arsinovgleb5-create/Mikola_Tesla-QCW-DRSSTC-controller/hardware/control_board/output/3d_bottom.png

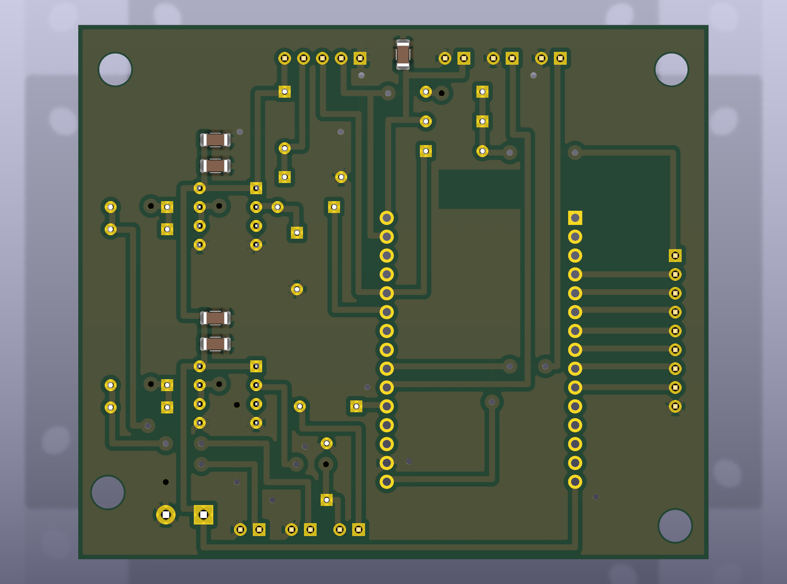
hardware/control_board/output/3d_bottom.png
