arsinovgleb5-create/Mikola_Tesla-QCW-DRSSTC-controller/hardware/control_board/output/bottom_copper.png

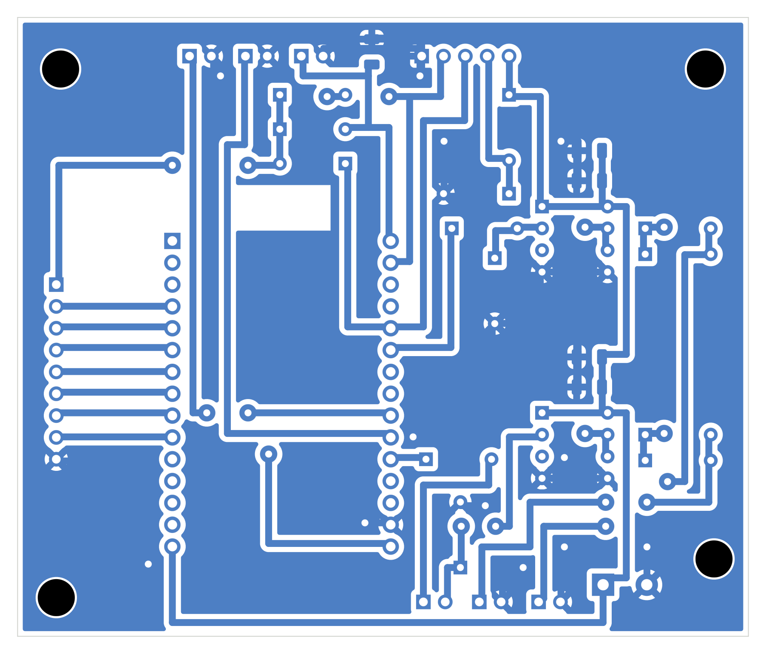
hardware/control_board/output/bottom_copper.png
