arsinovgleb5-create/Mikola_Tesla-QCW-DRSSTC-controller/hardware/control_board/output/schematic.png

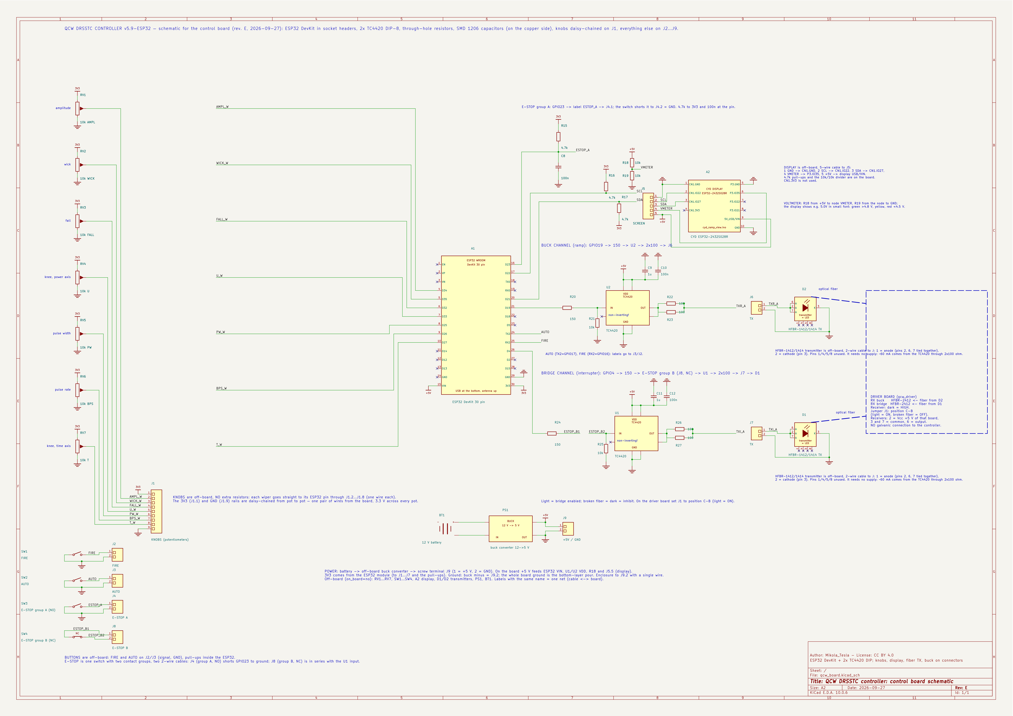
hardware/control_board/output/schematic.png
