arsinovgleb5-create/Mikola_Tesla-QCW-DRSSTC-controller/hardware/control_board/output/bottom_assembly.pdf

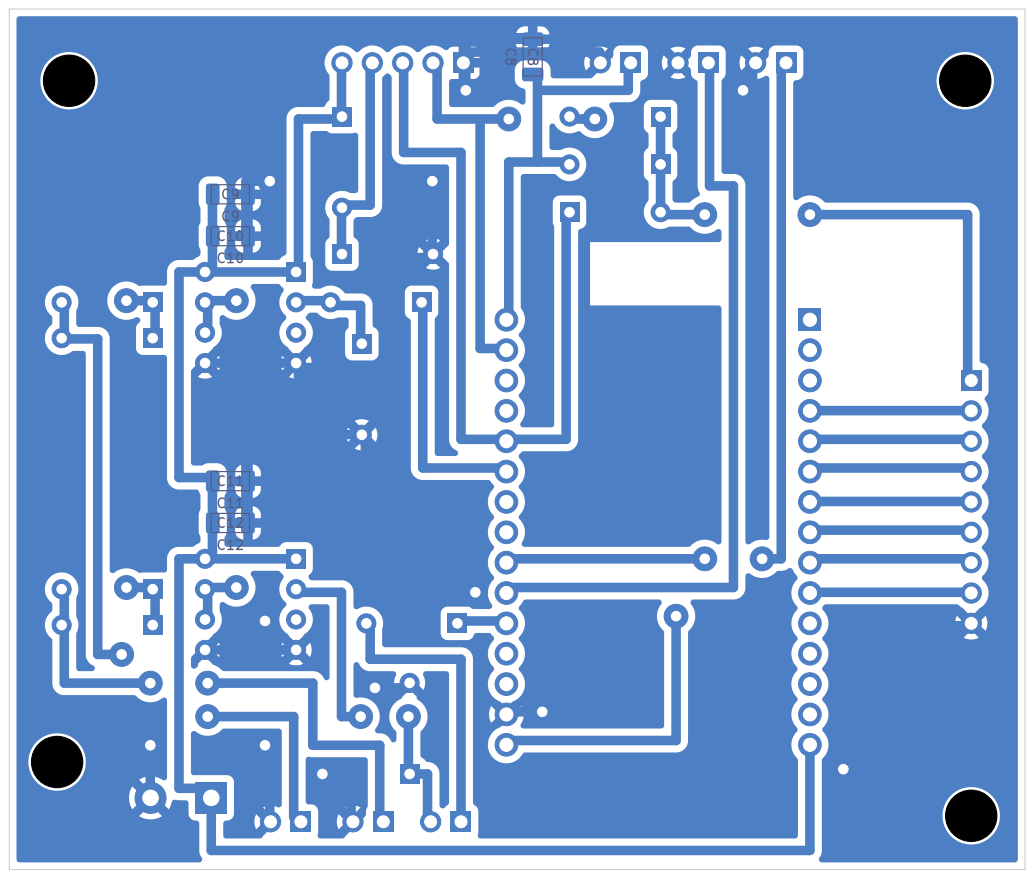
[picture p5: page 1]

Size: A4 | Rev:
KiCad E.D.A. 10.0.6 | Id: 1/1
