arsinovgleb5-create/Mikola_Tesla-QCW-DRSSTC-controller/hardware/control_board/output/top_assembly.pdf

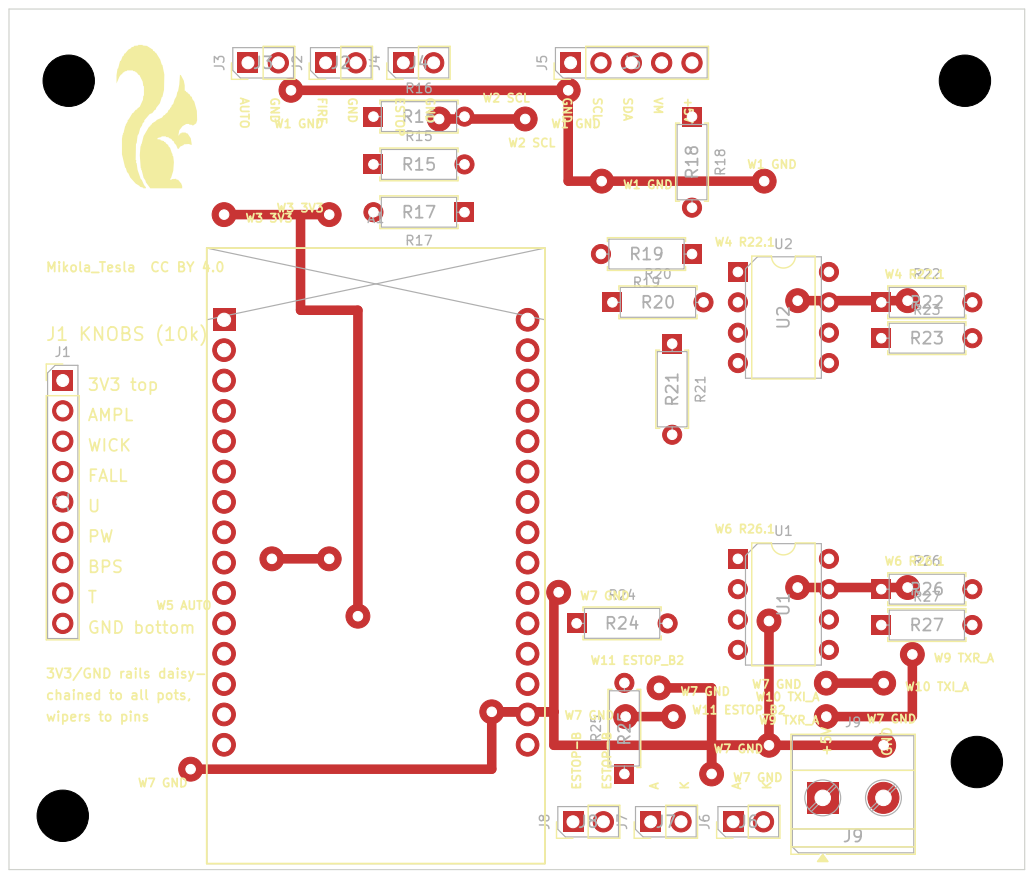
[picture p7: page 1]

AK AUTO GND FIRE GND ESTOP GND GND SCL SDA VM+5V Mikola_Tesla CC BY 4.0

Size: A4 | Rev:
KiCad E.D.A. 10.0.6 | Id: 1/1
