arsinovgleb5-create/Mikola_Tesla-QCW-DRSSTC-controller/hardware/control_board/output/bottom_copper_1to1.pdf

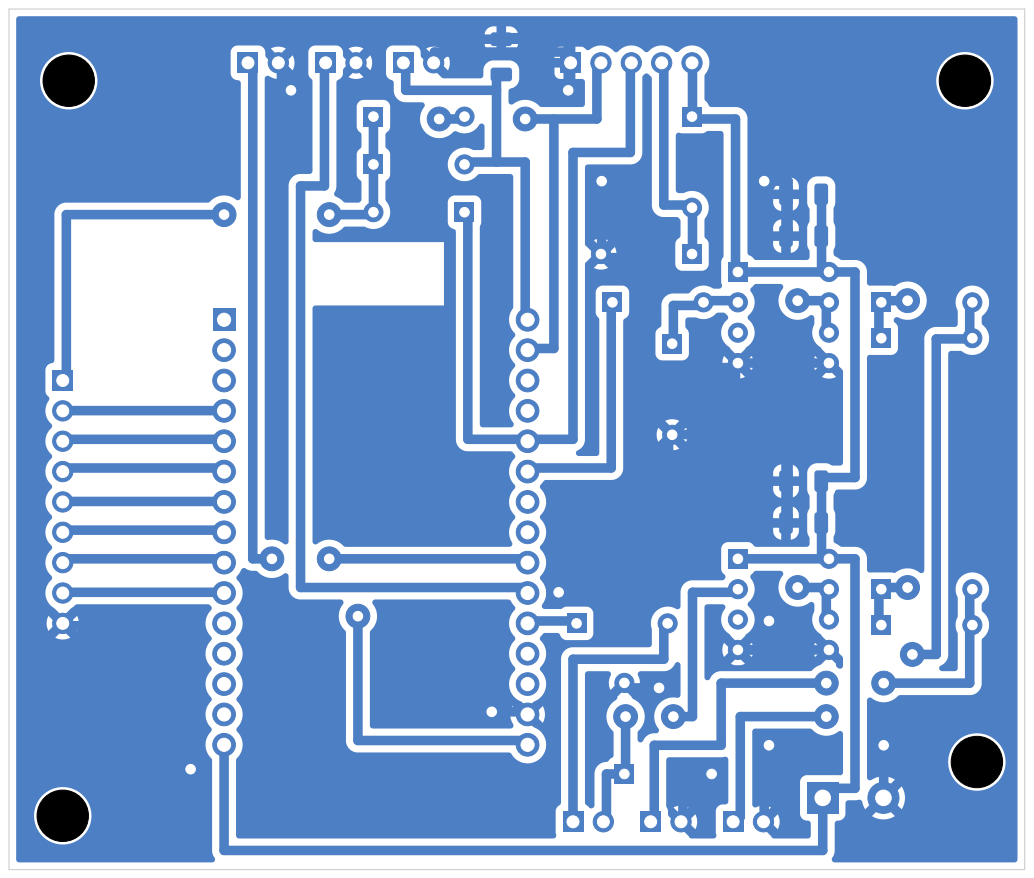
[picture p8: page 1]
