arsinovgleb5-create/Mikola_Tesla-QCW-DRSSTC-controller/hardware/control_board/output/bottom_copper_1to1_mirrored.pdf

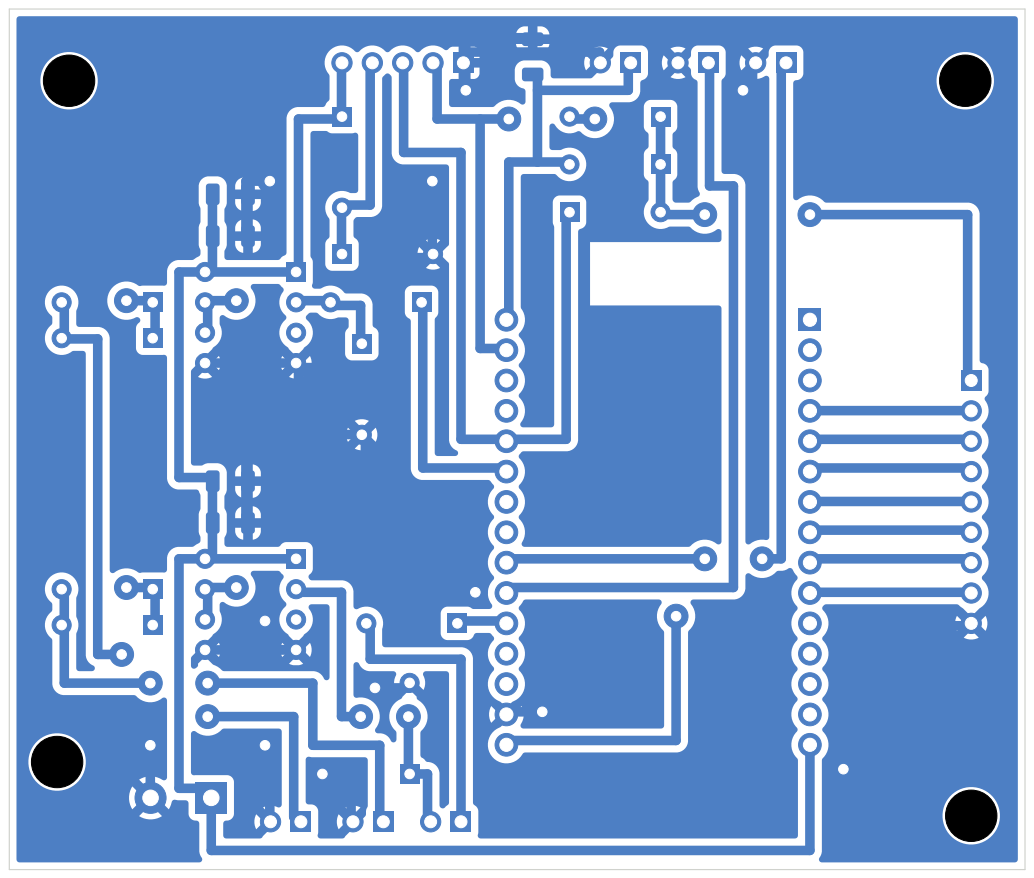
[picture p9: page 1]
