arsinovgleb5-create/Mikola_Tesla-QCW-DRSSTC-controller/hardware/control_board/output/drill_map.pdf

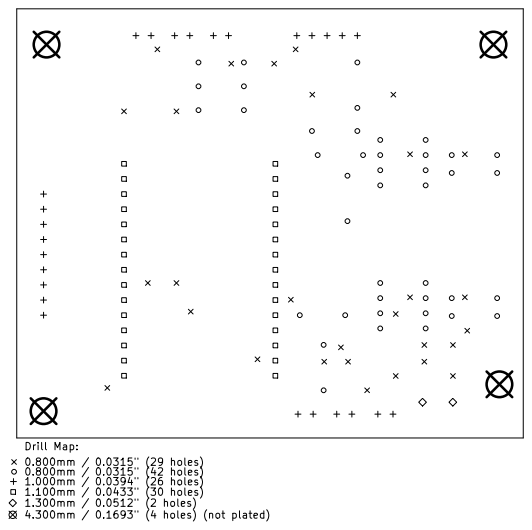
[picture p10: page 1]
