arsinovgleb5-create/Mikola_Tesla-QCW-DRSSTC-controller/hardware/control_board/kicad/qcw_board.kicad_pcb

## KiCad design hardware/control_board/kicad/qcw_board.kicad_pcb (2026-09-27)

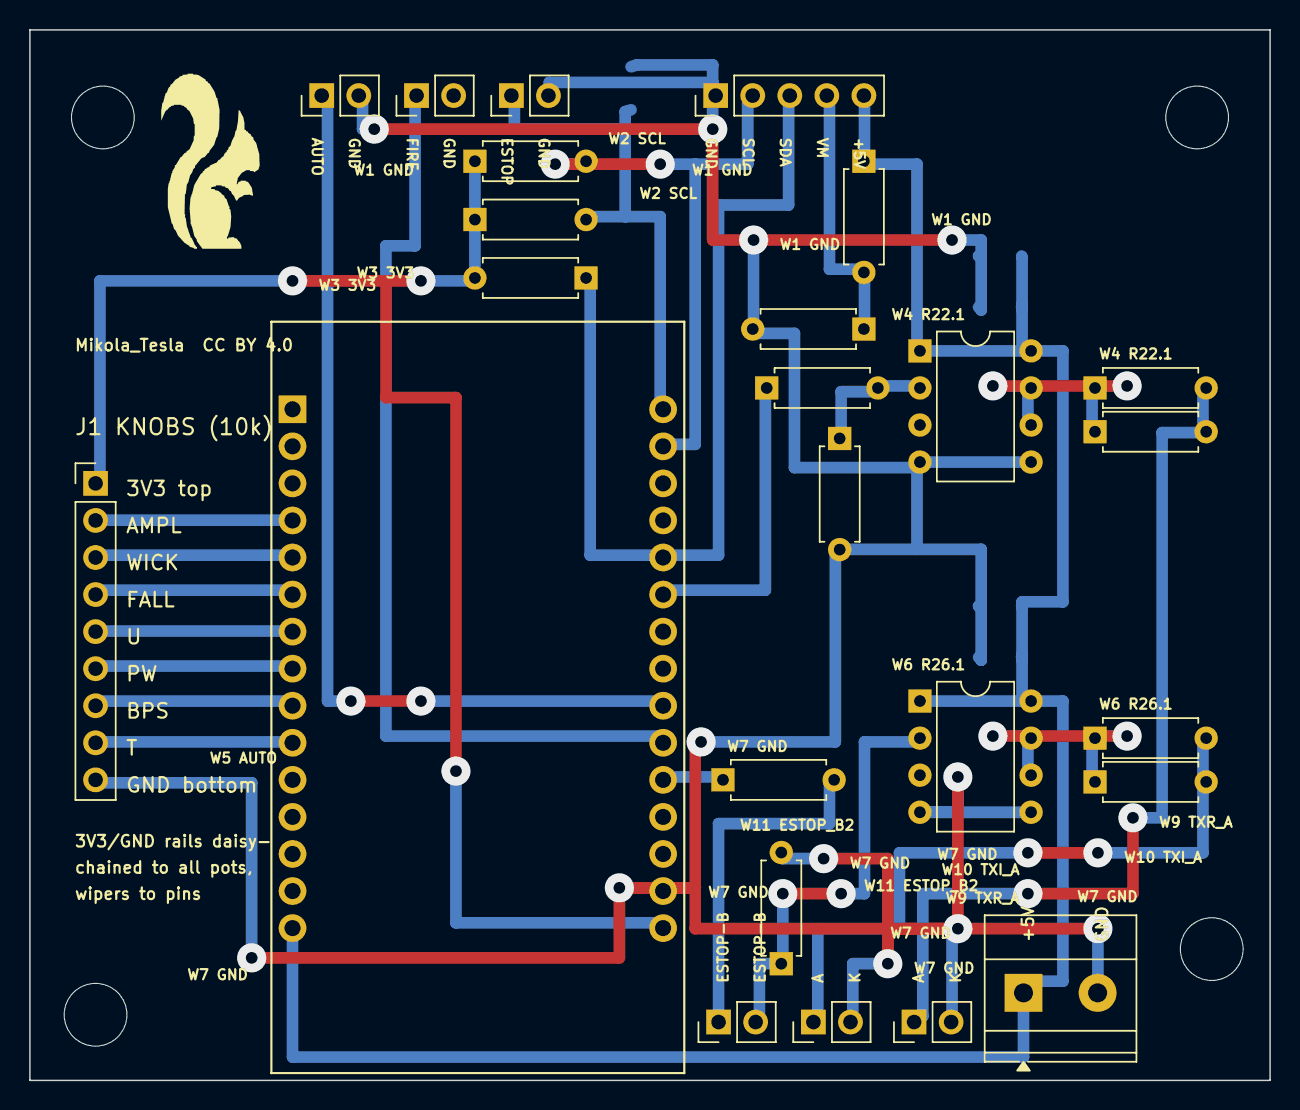
[picture p11: board qcw_board.kicad_pcb from above]

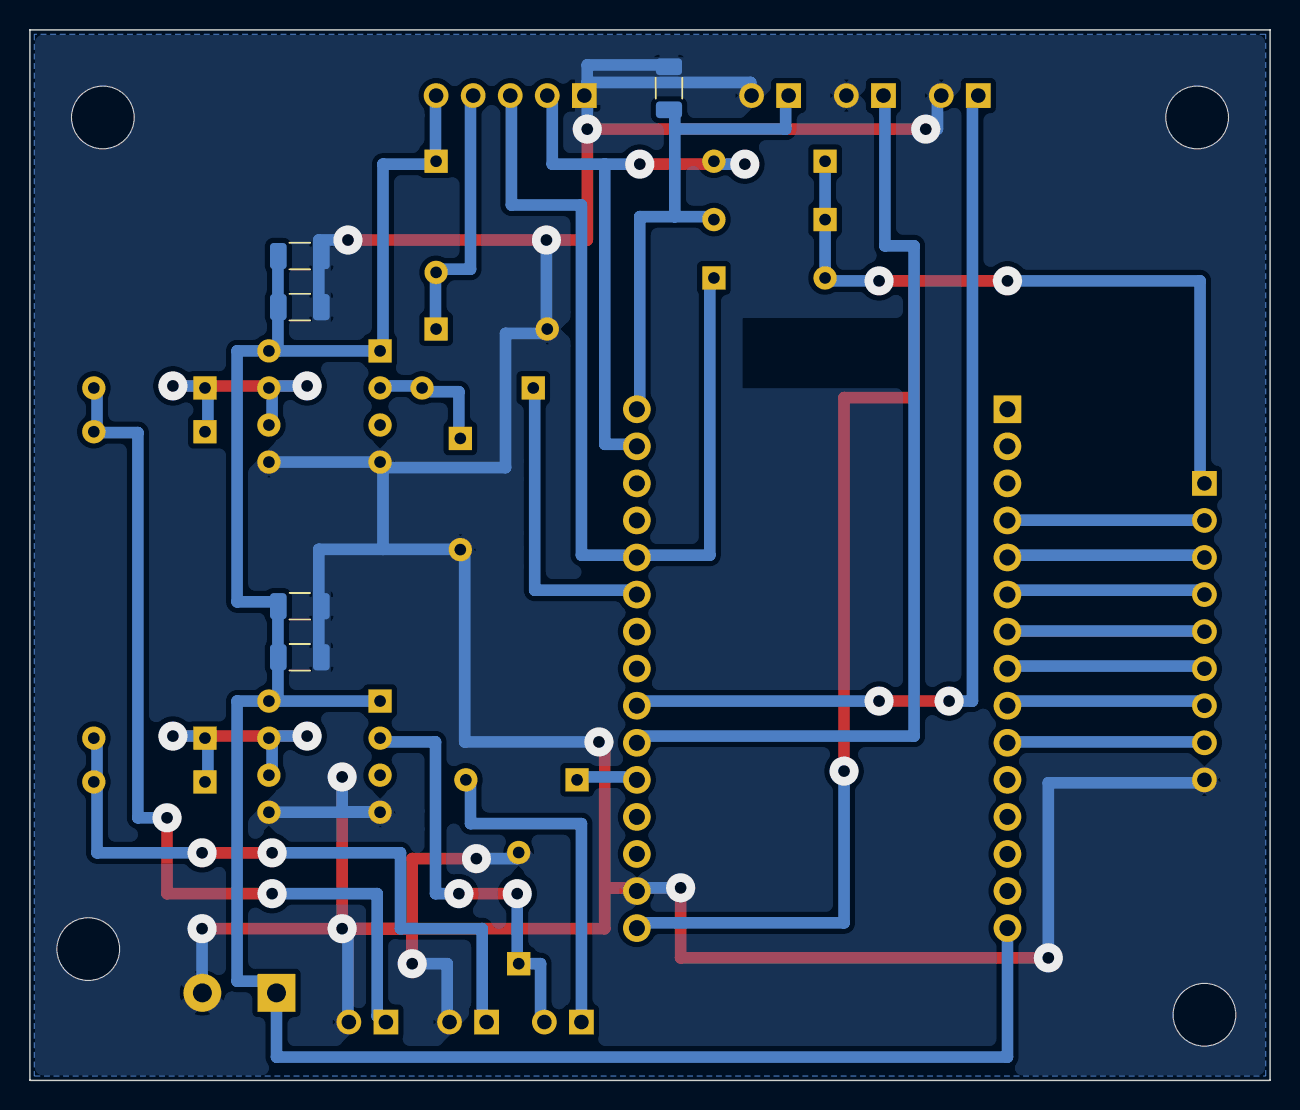
[picture p12: board qcw_board.kicad_pcb from below]

Board: 2 copper layers, 85.0 x 72.0 mm, 34 parts (5 on the bottom side), 25 nets.

Parts:
A1: ESP32 DevKit 30 pin; ESP32_DevKit_30
C8, C10, C12: 100n; C_1206_3216Metric
C9, C11: 1u; C_1206_3216Metric
H1, H2, H3, H4: MountingHole_4.3mm_M4
J1: KNOBS (potentiometers); PinHeader_1x09_wide
J2: FIRE; PinHeader_1x02_wide
J3: AUTO; PinHeader_1x02_wide
J4: E-STOP A; PinHeader_1x02_wide
J5: SCREEN; PinHeader_1x05_wide
J6, J7: TX; PinHeader_1x02_wide
J8: E-STOP B; PinHeader_1x02_wide
J9: +5V / GND; TerminalBlock_2_wide
R15, R16, R17: 4.7k; R_Axial_P7.62_wide
R18, R19, R21, R25: 10k; R_Axial_P7.62_wide
R20, R24: 150; R_Axial_P7.62_wide
R22, R23, R26, R27: 100; R_Axial_P7.62_wide
U1, U2: TC4420; DIP-8_W7.62mm_wide

Connections:
3V3: A1.30, J1.1, R15.1, R16.1, R17.2
+5V: A1.15, C9.2, C10.2, C11.2, C12.2, J5.5, J9.1, R18.1, U1.1, U1.8, U2.1, U2.8
/AMPL_W: A1.4, J1.2
/AUTO: A1.24, J3.1
/BPS_W: A1.9, J1.7
/ESTOP_A: A1.16, C8.1, J4.1, R15.2
/ESTOP_B1: J8.1, R24.2
/ESTOP_B2: J8.2, R25.1, U1.2
/FALL_W: A1.6, J1.4
/FIRE: A1.25, J2.1
/PW_W: A1.8, J1.6
/SCL: A1.17, J5.2, R16.2
/SDA: A1.20, J5.3, R17.1
/TXI_A: J7.1, R26.2, R27.2
/TXR_A: J6.1, R22.2, R23.2
/T_W: A1.10, J1.8
/U_W: A1.7, J1.5
/VMETER: J5.4, R18.2, R19.1
/WICK_W: A1.5, J1.3
GND: A1.29, C8.2, C9.1, C10.1, C11.1, C12.1, J1.9, J2.2, J3.2, J4.2, J5.1, J6.2, J7.2, J9.2, R19.2, R21.2, R25.2, U1.4, U1.5, U2.4, U2.5
unnamed: A1.26, R24.1
unnamed: A1.21, R20.1
unnamed: R22.1, R23.1, U2.6, U2.7
unnamed: R26.1, R27.1, U1.6, U1.7
unnamed: R20.2, R21.1, U2.2
